userdorukhan/rfgenerator/(list of files, drawings)

Other design files:
PCB/PA107_PCB (5-24-2026 8-40-11 PM)/PA107_PCB.PrjPcb
PCB/PA107_PCB (5-24-2026 8-40-11 PM)/PA107_Schematic.SchDoc
PCB/PA107_PCB (5-24-2026 8-40-11 PM)/PCB1.PcbDoc
