userdorukhan/rfgenerator/Firmware/RFGeneratormain.ioc

Mcu.UserName=STM32H723ZGTx
PA13(JTMS/SWDIO).GPIO_Label=SWDIO
PA13(JTMS/SWDIO).Signal=DEBUG_JTMS-SWDIO
PA14(JTCK/SWCLK).GPIO_Label=SWCLK
PA14(JTCK/SWCLK).Signal=DEBUG_JTCK-SWCLK
PC14-OSC32_IN.Signal=RCC_OSC32_IN
PC15-OSC32_OUT.Signal=RCC_OSC32_OUT
PD8.Signal=USART3_TX
PD9.Signal=USART3_RX
PE11.Signal=GPIO_Output
PE14.Signal=GPIO_Output
PE9.Signal=GPIO_Output
PG12.Signal=GPIO_Output
