userdorukhan/rfgenerator/Firmware/Core/Inc/main.h

#define SWDIO_Pin GPIO_PIN_13
#define SWDIO_GPIO_Port GPIOA
#define SWCLK_Pin GPIO_PIN_14
#define SWCLK_GPIO_Port GPIOA
#define AD9851_W_CLK_Pin GPIO_PIN_12
#define AD9851_W_CLK_GPIO_Port GPIOG
#define AD9851_FQ_UD_Pin GPIO_PIN_9
#define AD9851_FQ_UD_GPIO_Port GPIOE
#define AD9851_DATA_Pin GPIO_PIN_11
#define AD9851_DATA_GPIO_Port GPIOE
#define AD9851_RESET_Pin GPIO_PIN_14
#define AD9851_RESET_GPIO_Port GPIOE
