userdorukhan/rfgenerator/(commit log)

2026-04-09 Automated the UART input
2026-05-24 PCB documentaion draft
2026-05-25 Added pcb files
    [PA107_PCB.PrjPcb, PA107_Schematic.SchDoc, PCB1.PcbDoc]
